walei163/swm3310/README.md

# swm3310
基于英博公司定制开发的61850转换模组，核心板采用sanway的SWA153D
