walei163/swm3310/V1.0_20260109/DOC/客户技术及验证需求/昇伟__61850_通讯核心板卡出厂测试流程及标准文档.docx

# 61850 通讯核心板卡出厂测试流程及标准文档

项目 | 内容
文档名称 | 测试文档
板卡型号 | SWA1530
文档版本 | V1.0
编制日期 | 2026.1.23
编制部门 | 廊坊研发中心
适用范围 | 供应商出厂测试、项目组内部评估
文档状态 | 初稿

## 1. 文档概述

### 1.1 目的描述

1. 验证 SWA5043 板卡61850 协议核心功能：串口转 61850 协议转换准确性、数据传输延迟、协议兼容性（MMS/GOOSE）；
2. 验证板卡硬件与配置工具可用性：网口 / 串口配置、Web 管理、程序升级、文件传输等功能有效性；
3. 明确出厂测试标准：为供应商提供可量化的测试指标、流程及判定依据，确保批量交付板卡一致性。
4. 出场时按照实际要求设置默认程序 ，默认参数

### 1.2 测试环境准备

#### 1.2.1 硬件环境（供应商需配备）

设备名称 | 规格要求 | 数量 | 用途
测试主机 | 测试电脑 | 1 台 | 运行测试工具、Web 登录配置
61850 协议分析仪 （抓包工具） | ，报文捕获 / 解析 | 1 台 | 验证 MMS/GOOSE 报文合法性
串口模拟器（Modbus Slave） | 支持 Modbus RTU/TCP 协议 | 1 台 | 模拟 PCS 串口数据输入
以太网交换机 | 网口≥4 个 | 1 台 | 连接测试主机、板卡、分析仪
直流电源 | 输出 5V（匹配板卡供电），纹波≤5% | 1 台 | 板卡供电
万用表 / 示波器 | 精度≥0.1%，支持电压 / 波形测量 | 各 1 台 | 检测供电稳定性、GPIO 状态
辅助工具 | USB-TTL 转换器、网线、5V 电源 | 若干 | 串口调试、设备互联

#### 1.2.2 软件环境（供应商需安装）

软件名称 | 版本要求 | 用途
61850 测试工具 | IEDScout/UDMView 等 | MMS 服务测试、GOOSE 订阅 / 发布验证
抓包工具 | Wireshark等 | 辅助分析以太网报文
串口调试工具 | MobaXterm、串口助手等 | 串口数据监控、板卡调试
Modbus 测试工具 | Modbus Slave等 | 模拟 PCS 串口数据输出
配置文件编辑工具 | XML 编辑器、Excel等 | 修改 icd 文件、goose.csv 配置文件
板卡配套文件 | ybdq_pcs_so_xml_v1_20260121.tar.gz（应用程序）、rs201.icd（模型文件）、goose.csv（GOOSE 配置）、protocol.xml（点表配置）等 | 板卡程序升级、功能配置

## 2. 功能验证（出厂必测项）

### 2.1 基础通讯配置功能测试

#### 测试目的

验证板卡网口、串口参数修改有效性，配置重启后是否正常生效。

#### 测试步骤

1. 初始状态检查：
  1. 板卡上电，通过 Web 登录（默认 IP），记录初始网口配置（IP 地址、子网掩码、网关）和串口配置（波特率、数据位、校验位）；
  2. 使用 ping 命令测试默认 IP 连通性，通过串口工具验证默认串口通讯正常。
1. 参数修改操作：
  3. 登录 Web 管理页面，进入 “通讯功能配置”：
    1. 网口配置：修改所有网口 IP 地址、子网掩码、网关（示例：IP=192.168.1.100，子网掩码 = 255.255.255.0，网关 = 192.168.1.1）；
    2. 串口配置：修改串口波特率（如 9600→19200）、数据位（8 位）、校验位（无）、停止位（1 位）；
    3. 启用 NTP 对时（服务器 IP=202.120.2.101），配置 GOOSE 绑定网口（如 eth1）。
1. 生效验证：
  4. 保存配置并重启板卡，等待 3 分钟后重新登录 Web；
  5. 核查网口、串口、NTP、GOOSE 网口配置是否与修改后一致；
  6. 使用新 IP 测试 ping 连通性，通过串口工具（新参数）验证串口通讯正常。

#### 判定标准

5. 配置修改后重启生效，Web 页面显示参数与修改值一致；
6. 新 IP 地址 ping 测试成功率 100%（连续 ping 100 次无丢包）；
7. 串口通讯正常，无数据丢失或乱码。

### 2.2 工具操作功能测试

#### 2.2.1 Web 登录测试

8. 测试步骤：通过测试主机浏览器输入板卡网口 IP，验证是否能正常访问 Web 管理页面（无需额外插件）；
9. 判定标准：登录响应时间≤3 秒，页面无错乱、功能按钮可正常点击。

#### 2.2.2 程序升级测试

10. 测试步骤：
  1. 进入 Web “程序升级” 页面，选择板卡配套应用程序 例如（ybdq_pcs_so_xml_v1_20260121.tar.gz）等；
  2. 点击 “上传升级”，等待升级完成（约 5 分钟），板卡自动重启；
  3. 重启后登录 Web，核查程序版本是否与升级文件一致。
11. 判定标准：升级过程无中断、无报错；重启后程序版本正确，所有功能正常。

#### 2.2.3 文件上传 / 下载测试

12. 测试步骤：
  1. 上传测试：进入 Web “文件管理”，分别上传 icd 文件（rs201.icd）、GOOSE 配置文件（goose.csv）、点表配置文件（protocol.xml）；
  2. 下载测试：上传完成后，分别下载上述文件，与原文件对比是否一致。
13. 判定标准：文件上传 / 下载成功率 100%，下载文件与原文件 MD5 值一致（无篡改、无丢失）。

#### 2.2.4 工程配置测试

14. 测试步骤：
  1. 进入 Web “工程配置”，修改 iedname（如 “PCS-61850-001”）；
  2. 选择 icd 模型文件（如rs201.icd）、设备名、协议名，设置扫描时间为 100ms；
  3. 修改系统时间；
  4. 保存配置并重启，核查配置是否生效。
15. 判定标准：iedname、icd 模型、扫描时间、系统时间修改后均生效，系统时间误差≤1 秒。

#### 2.2.5 实时库配置测试

16. 测试步骤：
  1. 由供应商提供实时库修改支持，增加 1 个模拟点位（如 “PCS_Udc”，电压类型，字节序 = 大端）；
  2. 设置该点位串口读取周期可修改为 100ms；
  3. 通过串口模拟器发送该点位数据，验证板卡是否能正常采集。
17. 判定标准：实时库配置修改后生效，点位数据采集正常，读取周期误差≤10ms。

#### 2.2.6 ICD 文件配置修改测试

18. 测试步骤：
  1. 使用 XML 编辑器修改 rs201.icd 文件（如增加 1 个遥测点位）；
  2. 上传修改后的 icd 文件至板卡，重启后通过 61850 测试工具（IEDScout）解析板卡模型；
  3. 核查解析结果是否包含新增点位。
19. 判定标准：icd 文件修改后上传生效，61850 测试工具可正确解析新增点位信息。

#### 2.2.7 GOOSE 配置修改测试

20. 测试步骤：
  1. 用 Excel 编辑 goose.csv 文件，新增 1 个 GOOSE 发布数据集（如 “Dataset1”，包含 大于3 个点位）；
  2. 上传配置文件至板卡，重启后通过 61850 协议分析仪监控 GOOSE 报文；
  3. 核查分析仪是否能捕获到新增数据集的 GOOSE 发布报文。
21. 判定标准：GOOSE 配置修改生效，协议分析仪可捕获到合法的 GOOSE 发布报文（符合 IEC 61850 标准）。

### 2.3 MMS 协议功能测试

#### 2.3.1 测试准备

22. 加载文件：板卡上传 rs201.icd（icd 模型文件）、protocol.xml（点表映射文件）；
23. 测试工具：启动 IEDScout，建立与板卡的 MMS 连接（IP = 板卡网口 IP，端口 = 102）。

#### 2.3.2 MMS 读取测试

24. 测试步骤：
  1. 在 IEDScout 中浏览板卡模型，选择遥测点位（如电压、电流）、遥信点位（如运行状态）；
  2. 发起 “读数据” 请求，连续读取 100 次，记录读取结果；
  3. 通过串口模拟器修改点位数据，验证 MMS 读取是否同步更新。
25. 判定标准：
  1. 读取成功率 100%，无超时、无错误响应；
  2. 数据更新延迟≤200ms（串口数据修改后，MMS 读取到新数据的时间）；
  3. 读取数据与串口发送数据一致。

#### 2.3.3 MMS 设置操作测试

26. 测试步骤：
  1. 在 IedScout 中选择可写遥调点位（如输出功率设定值）；
  2. 发起 “写数据” 请求（如设定值 = 50kW），连续写入 10 次；
  3. 通过串口工具监控板卡下发至 PCS 的串口数据，核查设定值是否一致。
27. 判定标准：
  1. 写入成功率 100%，无写入失败或数据篡改；
  2. 串口下发数据与 MMS 写入数据一致，延迟≤200ms。

#### 2.3.4 离散数据显示测试

28. 测试步骤：
  1. 配置板卡离散数据点位（如故障告警位、运行模式位）；
  2. 通过串口模拟器发送离散数据（0/1 切换）；
  3. 在 IEDScout 中查看离散数据显示状态。
29. 判定标准：离散数据显示与串口发送状态一致，切换延迟≤100ms，无抖动。

### 2.4 GOOSE 协议功能测试

#### 2.4.1 测试准备

30. 加载文件：板卡上传 goose.csv（GOOSE 配置文件）、rs201.icd（icd 模型文件）、protocol.xml（点表映射文件）；
31. 测试工具：启动 61850 协议分析仪，接入板卡 GOOSE 网口。

#### 2.4.2 GOOSE 发送测试

32. 测试步骤：
  1. 板卡配置为 GOOSE 发布端，启用已配置的 GOOSE 数据集（如 Dataset1）；
  2. 通过串口模拟器发送数据集对应的点位数据（如电压 = 380V、电流 = 100A）；
  3. 协议分析仪捕获 GOOSE 报文，分析报文格式、数据集内容、发送周期。
33. 判定标准：
  1. GOOSE 报文符合 IEC 61850-8-1 标准，无格式错误。
  2. 报文发送周期与配置一致。
  3. 数据内容与串口发送数据一致。

#### 2.4.3 GOOSE 订阅测试

34. 测试步骤：
  1. 配置另一台 61850 设备作为 GOOSE 发布端，发送数据集（如 Dataset2，包含故障告警、电压值）；
  2. 板卡配置为 GOOSE 订阅端，订阅 Dataset2；
  3. 发布端修改数据集数据（如故障告警 = 1、电压 = 385V）；
  4. 通过板卡 Web 或串口工具查看订阅数据是否更新。
35. 判定标准：
  1. 板卡能成功订阅 GOOSE 报文，订阅成功率 100%；
  2. 订阅数据更新与发布端一致，延迟符合现场要求（符合储能 PCS 实时性要求）。

### 2.5 多网口兼容性测试

#### 测试步骤

1. 依次配置板卡所有网口（如 eth0、eth1、eth2）的 IP 地址（不同网段）；
2. 分别通过每个网口进行 MMS 通讯测试（读取 / 写入数据）、GOOSE 通讯测试（发布 / 订阅）；
3. 同时通过多个网口发起测试请求（如 eth0 进行 MMS 读取，eth1 进行 GOOSE 发送），持续 30 分钟。
36. 判定标准：
  1. 所有网口均能正常进行 MMS/GOOSE 通讯，无端口冲突；
  2. 多网口并发通讯时，无数据丢失、无响应超时，延迟符合要求。

## 3. 稳定性测试（出厂抽检项）

### 测试目的

验证板卡在长时间运行下的稳定性和可靠性。

### 测试步骤

1. 板卡正常配置后，连续运行 72 小时（模拟实际工况）；
2. 期间持续进行：
  3. MMS 通讯：每 100ms 读取 1 次遥测数据，每 1 秒写入 1 次遥调数据；
  4. GOOSE 通讯：每 50ms 发送 1 次 GOOSE 报文，订阅 1 路外部 GOOSE 数据；
  5. 串口数据交互：每 50ms 接收 PCS 模拟数据，每 1 秒下发控制指令；
1. 定期（每 2 小时）核查：
  6. 数据传输成功率、延迟是否符合标准；
  7. 板卡运行状态（温度、供电、无死机 / 重启）；
  8. 日志无报错信息。

### 判定标准

37. 72 小时运行期间，板卡无死机、无自动重启，供电稳定；
38. MMS/GOOSE/ 串口数据传输成功率≥99.99%，无数据丢失；
39. 延迟指标始终符合各功能测试要求，无明显漂移；
40. 运行日志无协议错误、通讯超时等异常记录。

## 4. 测试判定标准与记录

### 4.1 测试结果判定规则

测试结果等级 | 判定条件 | 处理方式
合格 | 所有必测项满足判定标准，抽检项（稳定性测试）无异常 | 允许出厂交付
不合格 | 任一必测项不满足判定标准，或抽检项出现严重异常（如死机、数据丢失） | 退回整改，整改后重新测试
待确认 | 个别测试项存在轻微偏差（如延迟偶尔超出范围），但不影响核心功能 | 复核测试，确认是否为偶然因素

### 4.2 出厂测试记录表格（供应商需填写）

#### 表 4-1 基础信息记录

板卡序列号 | 测试日期 | 测试人员 | 测试环境版本 | 备注

#### 表 4-2 功能测试记录

测试项目 | 测试用例 | 测试结果（合格 / 不合格 / 待确认） | 异常描述（若有） | 备注
基础通讯配置 | 网口参数修改生效
| 串口参数修改生效
| NTP 对时功能
工具操作 | Web 登录
| 程序升级
| 文件上传 / 下载
| 工程配置
| 实时库配置
MMS 功能 | 读取测试
| 写入测试
| 离散数据显示
GOOSE 功能 | 发送测试
| 订阅测试
多网口测试 | 多网口并发通讯

#### 表 4-3 稳定性测试记录（抽检）

测试时长 | 数据传输成功率 | 平均延迟 | 板卡运行状态 | 异常描述（若有） | 备注
24 小时
48 小时
72 小时

#### 表 4-4 测试结论

测试结论 | □ 合格 □ 不合格 □ 待确认
签字确认 | 测试人员：
| 审核人员：
| 日期：

## 5. 注意事项与异常处理

### 5.1 测试注意事项

1. 板卡上电前需确认供电电压与板卡要求一致（避免过压损坏）；
2. 配置文件（icd、goose.csv、protocol.xml）上传前需备份原文件，避免覆盖错误；
3. 修改 icd 文件点位信息时，需严格遵循 IEC 61850-6 标准，不建议自行修改核心点位；
4. Web 配置后需重启板卡才能生效，重启前需保存所有配置；
5. 多网口测试时，需确保各网口 IP 地址在不同网段，避免 IP 冲突；
6. 稳定性测试期间，禁止中断板卡供电或修改配置。

### 5.2 常见异常处理

异常现象 | 可能原因 | 处理方法
Web 登录失败 | IP 地址错误、网口未启用、网络不通 | 1. 核查板卡 IP 配置；2. 测试主机与板卡 ping 连通性；3. 更换网线或网口
配置文件上传失败 | 文件格式错误、文件过大 | 1. 确认文件符合要求（如 icd 为 XML 格式）；2. 拆分超大文件（若支持）；3. 刷新 Web 页面重试
MMS/GOOSE 通讯失败 | 模型文件加载错误、协议配置错误 | 1. 核查 icd 文件是否正确加载；2. 检查协议配置参数（如端口、数据集）；3. 用 Wireshark 抓包分析报文
数据传输延迟超标 | 网络拥堵、串口读取周期设置过大 | 1. 减少网络并发量；2. 调整串口读取周期或 GOOSE 发送周期；3. 检查网线质量（使用千兆网线）
板卡死机 / 重启 | 供电不稳定、程序异常 | 1. 用示波器检测供电纹波；2. 重新升级板卡程序；3. 记录死机前操作，反馈研发排查

## 6. 附录（测试用表）

### 附录 A：MD5 值校验表

配置文件名称 | 原文件 MD5 值 | 下载后 MD5 值 | 一致性判定（是 / 否）
rs201.icd
goose.csv
protocol.xml

### 附录 B：61850 协议测试关键指标参考

参考相关标准

指标类型 | 要求值 | 测试工具
MMS 读取延迟 | | IEDScout + 秒表
MMS 写入延迟 | | IEDScout + 秒表
GOOSE 发送周期误差 | | 61850 协议分析仪
GOOSE 订阅延迟 | | 61850 协议分析仪
数据传输成功率 | | 测试工具统计
