walei163/swm3310/V1.0_20260109/DOC/9pin接插件数据手册.png

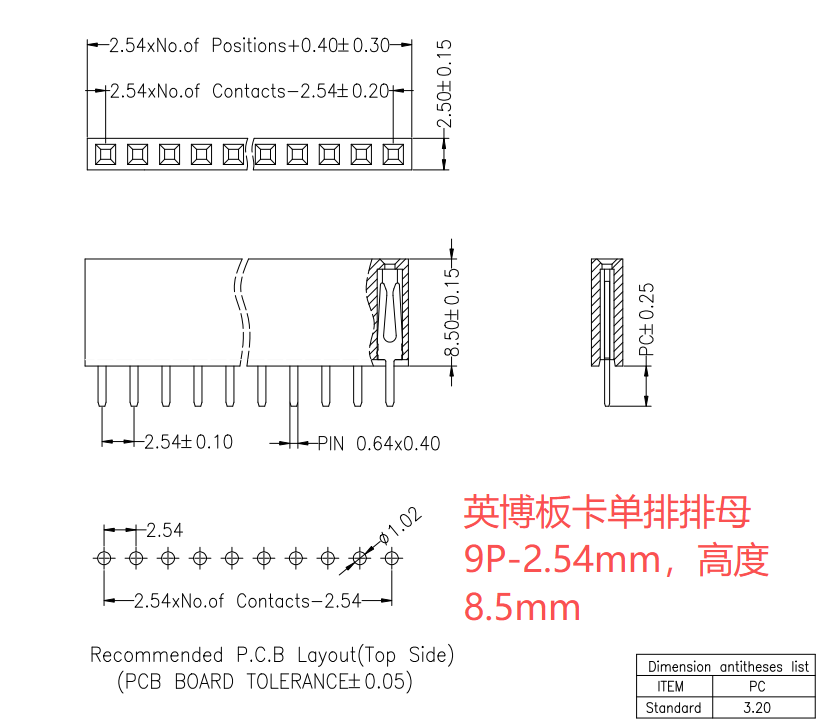
V1.0_20260109/DOC/9pin接插件数据手册.png
