walei163/swm3310/V1.0_20260109/DOC/images/image-20260109160413757.png

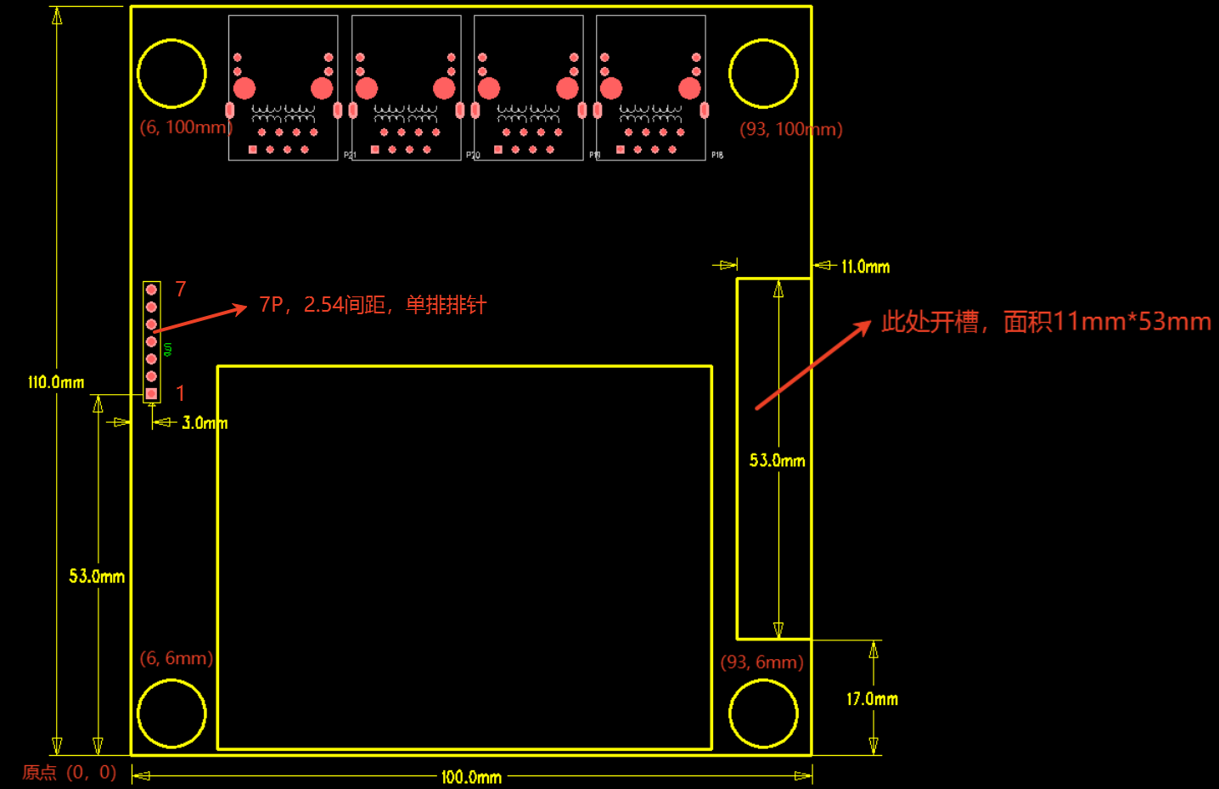
V1.0_20260109/DOC/images/image-20260109160413757.png
