walei163/swm3310/V1.0_20260109/DOC/客户方板卡CAN总线连接原理图.png

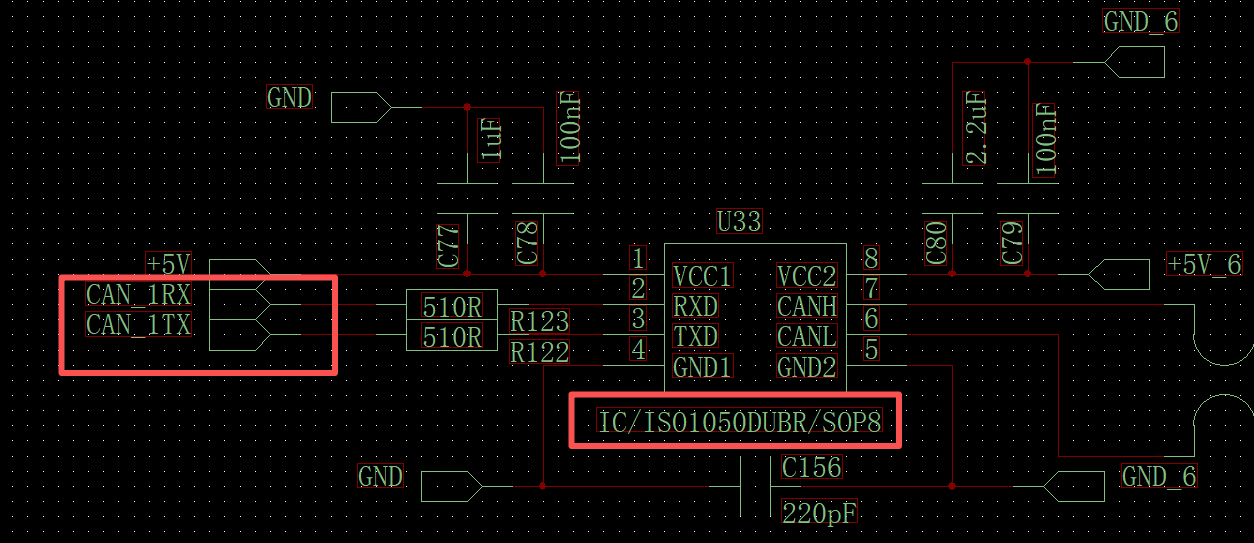
V1.0_20260109/DOC/客户方板卡CAN总线连接原理图.png
