walei163/swm3310/V1.0_20260109/DOC/接口尺寸图1.png

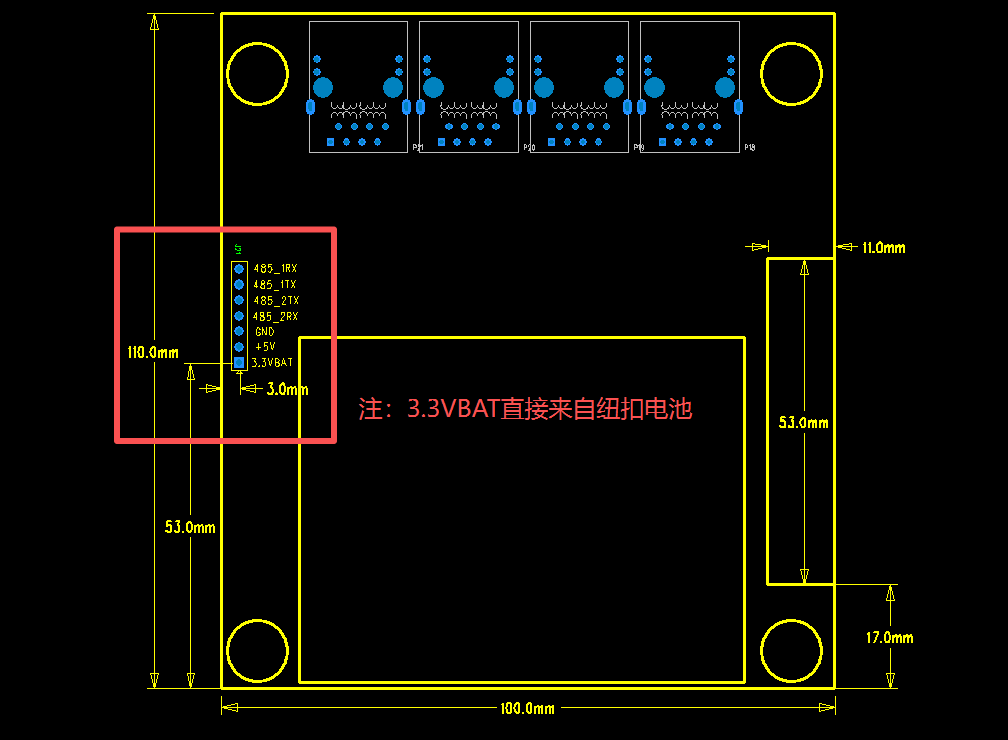
V1.0_20260109/DOC/接口尺寸图1.png
