walei163/swm3310/V1.0_20260109/PCB布局/SWM3310-0121.dxf

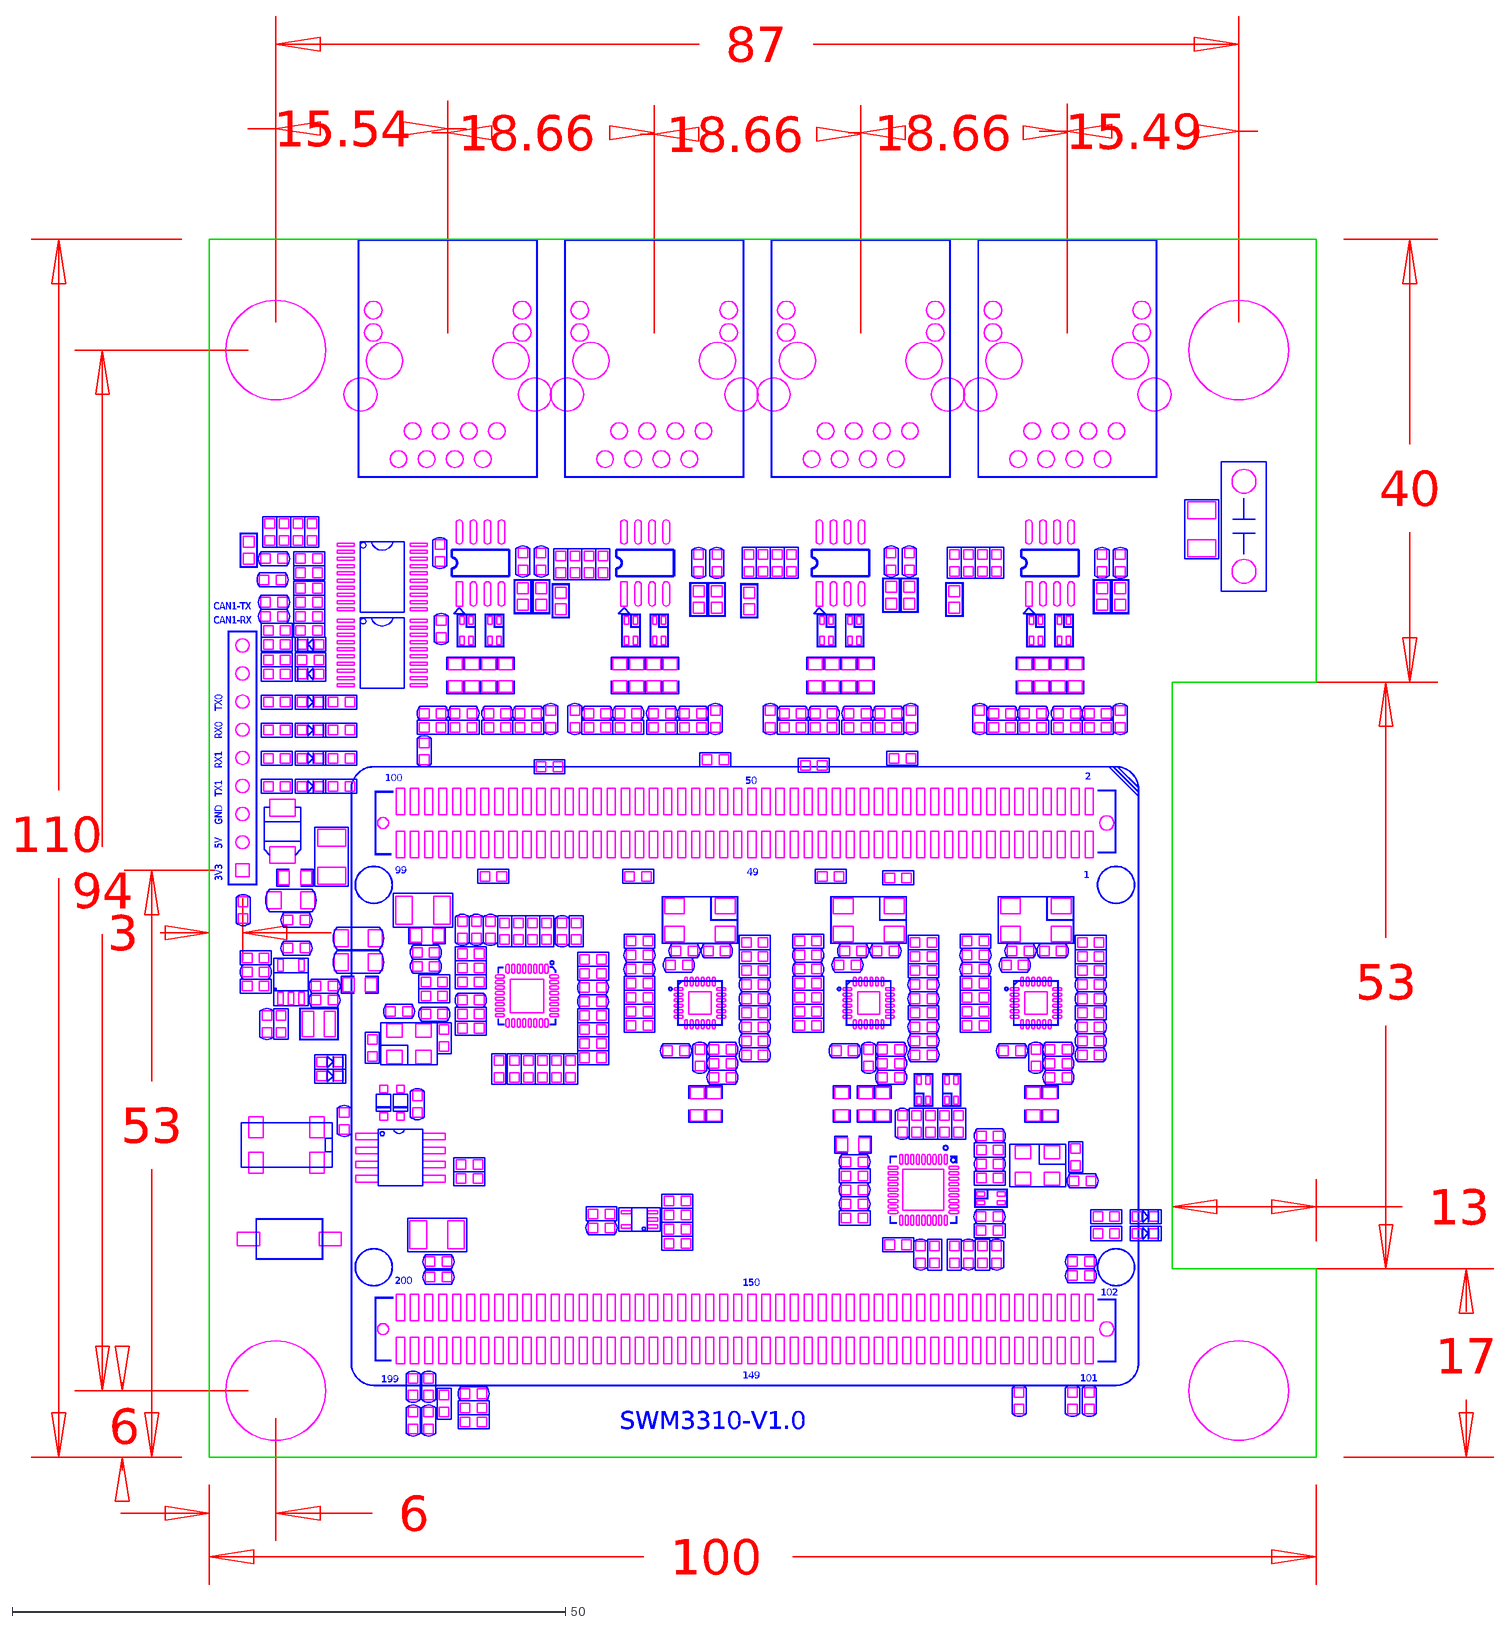
[picture p12: CAD file, 2026-01-28]
V1.0_20260109/PCB布局/SWM3310-0121.dxf
94
3
53
15.54
15.49
18.66
87
6
40
13
17
110
100
99
2
1
49
50
149
150
102
101
199
200
TX0
RX0
RX1
TX1
GND
5V
3V3
CAN1-RX
CAN1-TX
SWM3310-V1.0
