walei163/swm3310/V1.0_20260109/SCH/swm3310_SCH_V1.0_20260121.pdf

D | D

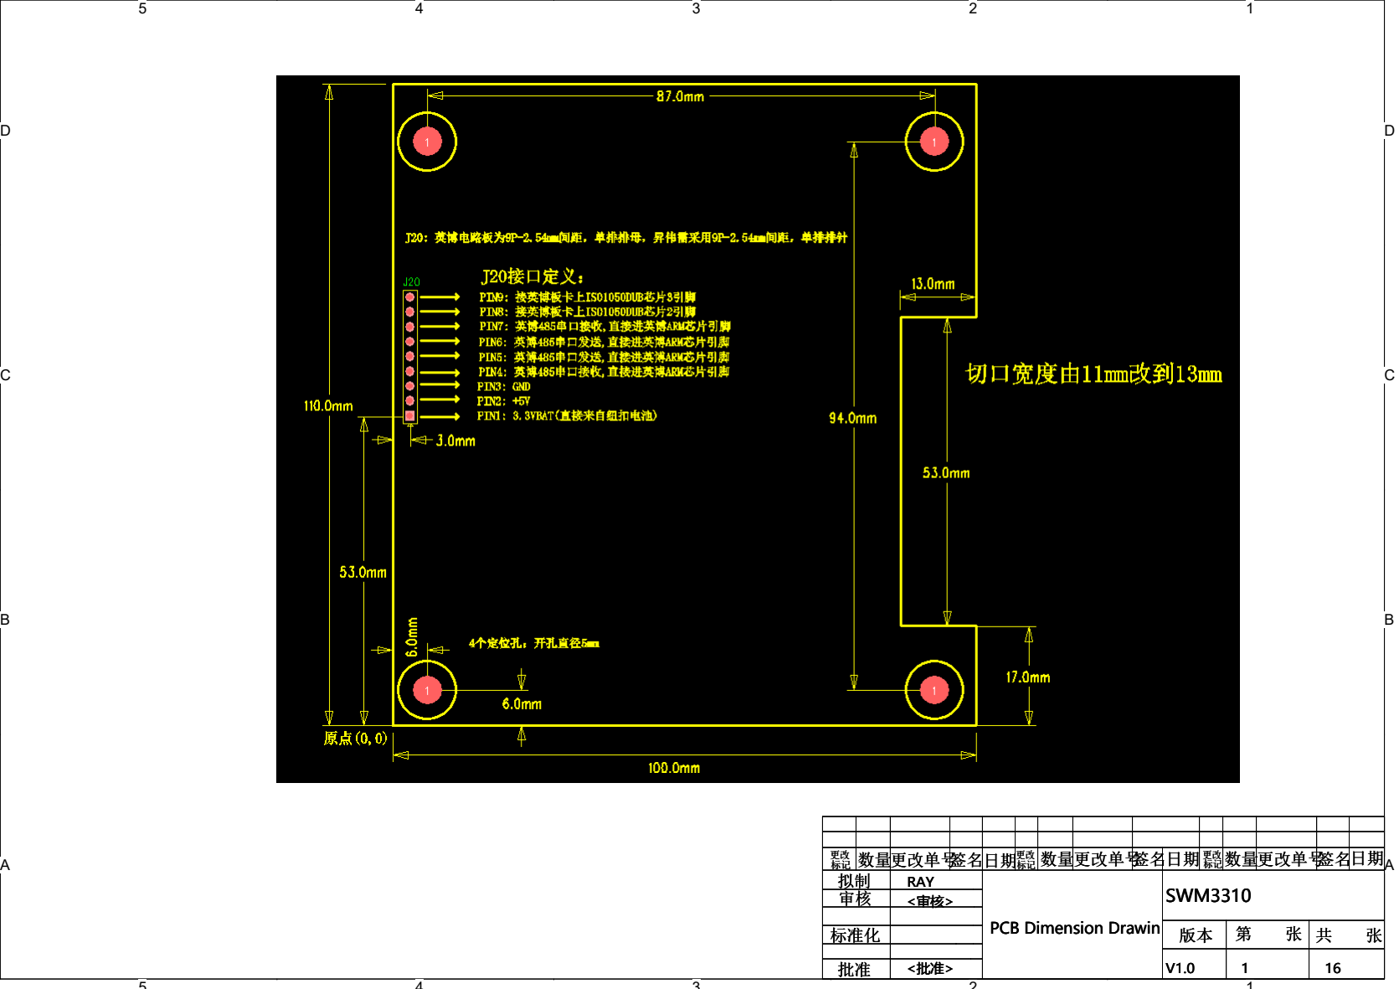
[picture p43: page 1]

C | C
B | B
A | 标标 | 数数更更更更签签日日 | A 更更
批批 | <批准>
版版 | 第　　张 | 共　　张
V1.0 V1.0 V1.0 | 1 1 1 | 16 16 16
标 标 | 数更更签日 更 数更更签日 更 | | | 更 更 更 标 标 标 | 数更更 数更更 数更更 | | 签 签日 更标 数更更 签 签日 更标 数更更 签 签日 更标 数更更 | 日 日 日
拟拟 拟拟 拟拟 | | RAY RAY RAY | PCB Dimension Drawin PCB Dimension Drawin PCB Dimension Drawin | | | SWM3310 SWM3310 SWM3310
审审 审审 审审 | | <审核> <审核> <审核>

# 标批标

D | D
C | C
B | B
A | A

34

2 | 系统逻辑框图
3 | 核心板对底板接插件1
4 | 核心板对底板接插件2
5 | USB HUB，将CPU第2路USB HOST扩展为4路输出
10 | 第3路以太网：采用USB扩展SR9900AI
11 | 第3路以太网RJ45接口电路

01/13/26

封面

1.1 6

13 | 第4路以太网RJ45接口电路
14 | 其它设计
15 | 主5V和主3.3V电源电路
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
PAGE NO.

7 | 第1路以太网RJ45接口电路
8 | 第2路以太网：采用USB扩展SR9900AI

## RAY

2.1

# REV

# FEATURE CHANGES

## 1、完完1.0版版版版版版版。

BY

2.2

9

# SCHEMATIC PAGE

# DESCRIPTION

## RAY

12

1.0

# DATE

# 第1路以太网PHY：采用RTL8201F PHY芯片

# 第2路以太网RJ45接口电路

# 第4路以太网：采用USB扩展SR9900AI

标 标 标 | 数更更签日 更 数更更签日 更 数更更签日 更 | | | 更 更 更 标 标 标 | 数更更 数更更 数更更 | | 签 签日 更标 数更更 签 签日 更标 数更更 签 签日 更标 数更更 | 日 日 日
拟拟 拟拟 拟拟 | | RAY.Wang RAY.Wang RAY.Wang | COVER COVER COVER | | | SWM3310 SWM3310 SWM3310
审审
<审核>
V1.0 | 2 | 16

审审
<审核>
V1.0 | 2 | 16

审审
<审核>
V1.0 | 2 | 16

UART X 3 TTL; PHY RTL8201F (100M); USB 2.0 X 1 (HOST); RMII; USB2512 (HUB); SIP7; SWA157D (STM32MP157DAA1)

标 标 标 | 数更更签日 更 数更更签日 更 数更更签日 更 | | | 更 更 更 标 标 标 | 数更更 数更更 数更更 | | 签 签日 更标 数更更 签 签日 更标 数更更 签 签日 更标 数更更 | 日 日 日
拟拟 拟拟 拟拟 | | RAY.Wang RAY.Wang RAY.Wang | SYSTEM_LOGIC SYSTEM_LOGIC SYSTEM_LOGIC | | | SWM3310 SWM3310 SWM3310

D | D


标 标 标 | 数更更签日 更 数更更签日 更 数更更签日 更 | | | 更 更 更 标 标 标 | 数更更 数更更 数更更 | | 签 签日 更标 数更更 签 签日 更标 数更更 签 签日 更标 数更更 | 日 日 日
拟拟 拟拟 拟拟 | | RAY.Wang RAY.Wang RAY.Wang | CPU_CONNECTOR1 CPU_CONNECTOR1 CPU_CONNECTOR1 | | | SWM3310 SWM3310 SWM3310
审审 审审 审审 | | <审核> <审核> <审核>

D | D

说明：


标 标 标 | 数更更签日 更 数更更签日 更 数更更签日 更 | | | 更 更 更 标 标 标 | 数更更 数更更 数更更 | | 签 签日 更标 数更更 签 签日 更标 数更更 签 签日 更标 数更更 | 日 日 日
拟拟 拟拟 拟拟 | | RAY.Wang RAY.Wang RAY.Wang | CPU_CONNECTOR2 CPU_CONNECTOR2 CPU_CONNECTOR2 | | | SWM3310 SWM3310 SWM3310
审审 审审 审审 | | <审核> <审核> <审核>

D | D

## Uptream


NON_REM[1:0] = 10: port 1 and 2 are non-removable
CFG_SEL[1:0] = 00

标 标 标 | 数更更签日 更 数更更签日 更 数更更签日 更 | | | 更 更 更 标 标 标 | 数更更 数更更 数更更 | | 签 签日 更标 数更更 签 签日 更标 数更更 签 签日 更标 数更更 | 日 日 日
拟拟 拟拟 拟拟 | | RAY.Wang RAY.Wang RAY.Wang | USB_HUB USB_HUB USB_HUB | | | SWM3310 SWM3310 SWM3310
审审 审审 审审 | | <审核> <审核> <审核>

D | D


标 标 标 | 数更更签日 更 数更更签日 更 数更更签日 更 | | | 更 更 更 标 标 标 | 数更更 数更更 数更更 | | 签 签日 更标 数更更 签 签日 更标 数更更 签 签日 更标 数更更 | 日 日 日
拟拟 拟拟 拟拟 | | RAY.Wang RAY.Wang RAY.Wang | PHY_RTL8201F PHY_RTL8201F PHY_RTL8201F | | | SWM3310 SWM3310 SWM3310
审审 审审 审审 | | <审核> <审核> <审核>

D | D


7 | | ENET1_TXP ENET1_TXN ENET1_RXP ENET1_RXN

标 标 标 | 数更更签日 更 数更更签日 更 数更更签日 更 | | | 更 更 更 标 标 标 | 数更更 数更更 数更更 | | 签 签日 更标 数更更 签 签日 更标 数更更 签 签日 更标 数更更 | 日 日 日
拟拟 拟拟 拟拟 | | RAY.Wang RAY.Wang RAY.Wang | PHY_RJ45 PHY_RJ45 PHY_RJ45 | | | SWM3310 SWM3310 SWM3310
审审 审审 审审 | | <审核> <审核> <审核>

D | D


标 标 标 | 数更更签日 更 数更更签日 更 数更更签日 更 | | | 更 更 更 标 标 标 | 数更更 数更更 数更更 | | 签 签日 更标 数更更 签 签日 更标 数更更 签 签日 更标 数更更 | 日 日 日
拟拟 拟拟 拟拟 | | RAY.Wang RAY.Wang RAY.Wang | ENET2_SR9900AI ENET2_SR9900AI ENET2_SR9900AI | | | SWM3310 SWM3310 SWM3310
审审 审审 审审 | | <审核> <审核> <审核>

D | D


7 | | TSEC2_TXP TSEC2_TXN TSEC2_RXP TSEC2_RXN

标 标 标 | 数更更签日 更 数更更签日 更 数更更签日 更 | | | 更 更 更 标 标 标 | 数更更 数更更 数更更 | | 签 签日 更标 数更更 签 签日 更标 数更更 签 签日 更标 数更更 | 日 日 日
拟拟 拟拟 拟拟 | | RAY.Wang RAY.Wang RAY.Wang | ENET2_RJ45 ENET2_RJ45 ENET2_RJ45 | | | SWM3310 SWM3310 SWM3310
审审 审审 审审 | | <审核> <审核> <审核>

D | D


标 标 标 | 数更更签日 更 数更更签日 更 数更更签日 更 | | | 更 更 更 标 标 标 | 数更更 数更更 数更更 | | 签 签日 更标 数更更 签 签日 更标 数更更 签 签日 更标 数更更 | 日 日 日
拟拟 拟拟 拟拟 | | RAY.Wang RAY.Wang RAY.Wang | ENET3_SR9900A ENET3_SR9900A ENET3_SR9900A | | | SWM3310 SWM3310 SWM3310
审审 审审 审审 | | <审核> <审核> <审核>

D | D


标 标 标 | 数更更签日 更 数更更签日 更 数更更签日 更 | | | 更 更 更 标 标 标 | 数更更 数更更 数更更 | | 签 签日 更标 数更更 签 签日 更标 数更更 签 签日 更标 数更更 | 日 日 日
拟拟 拟拟 拟拟 | | RAY.Wang RAY.Wang RAY.Wang | ENET3_RJ45 ENET3_RJ45 ENET3_RJ45 | | | SWM3310 SWM3310 SWM3310
审审 审审 审审 | | <审核> <审核> <审核>

D | D


标 标 标 | 数更更签日 更 数更更签日 更 数更更签日 更 | | | 更 更 更 标 标 标 | 数更更 数更更 数更更 | | 签 签日 更标 数更更 签 签日 更标 数更更 签 签日 更标 数更更 | 日 日 日
拟拟 拟拟 拟拟 | | RAY.Wang RAY.Wang RAY.Wang | ENET4_SR9900A ENET4_SR9900A ENET4_SR9900A | | | SWM3310 SWM3310 SWM3310
审审 审审 审审 | | <审核> <审核> <审核>

D | D

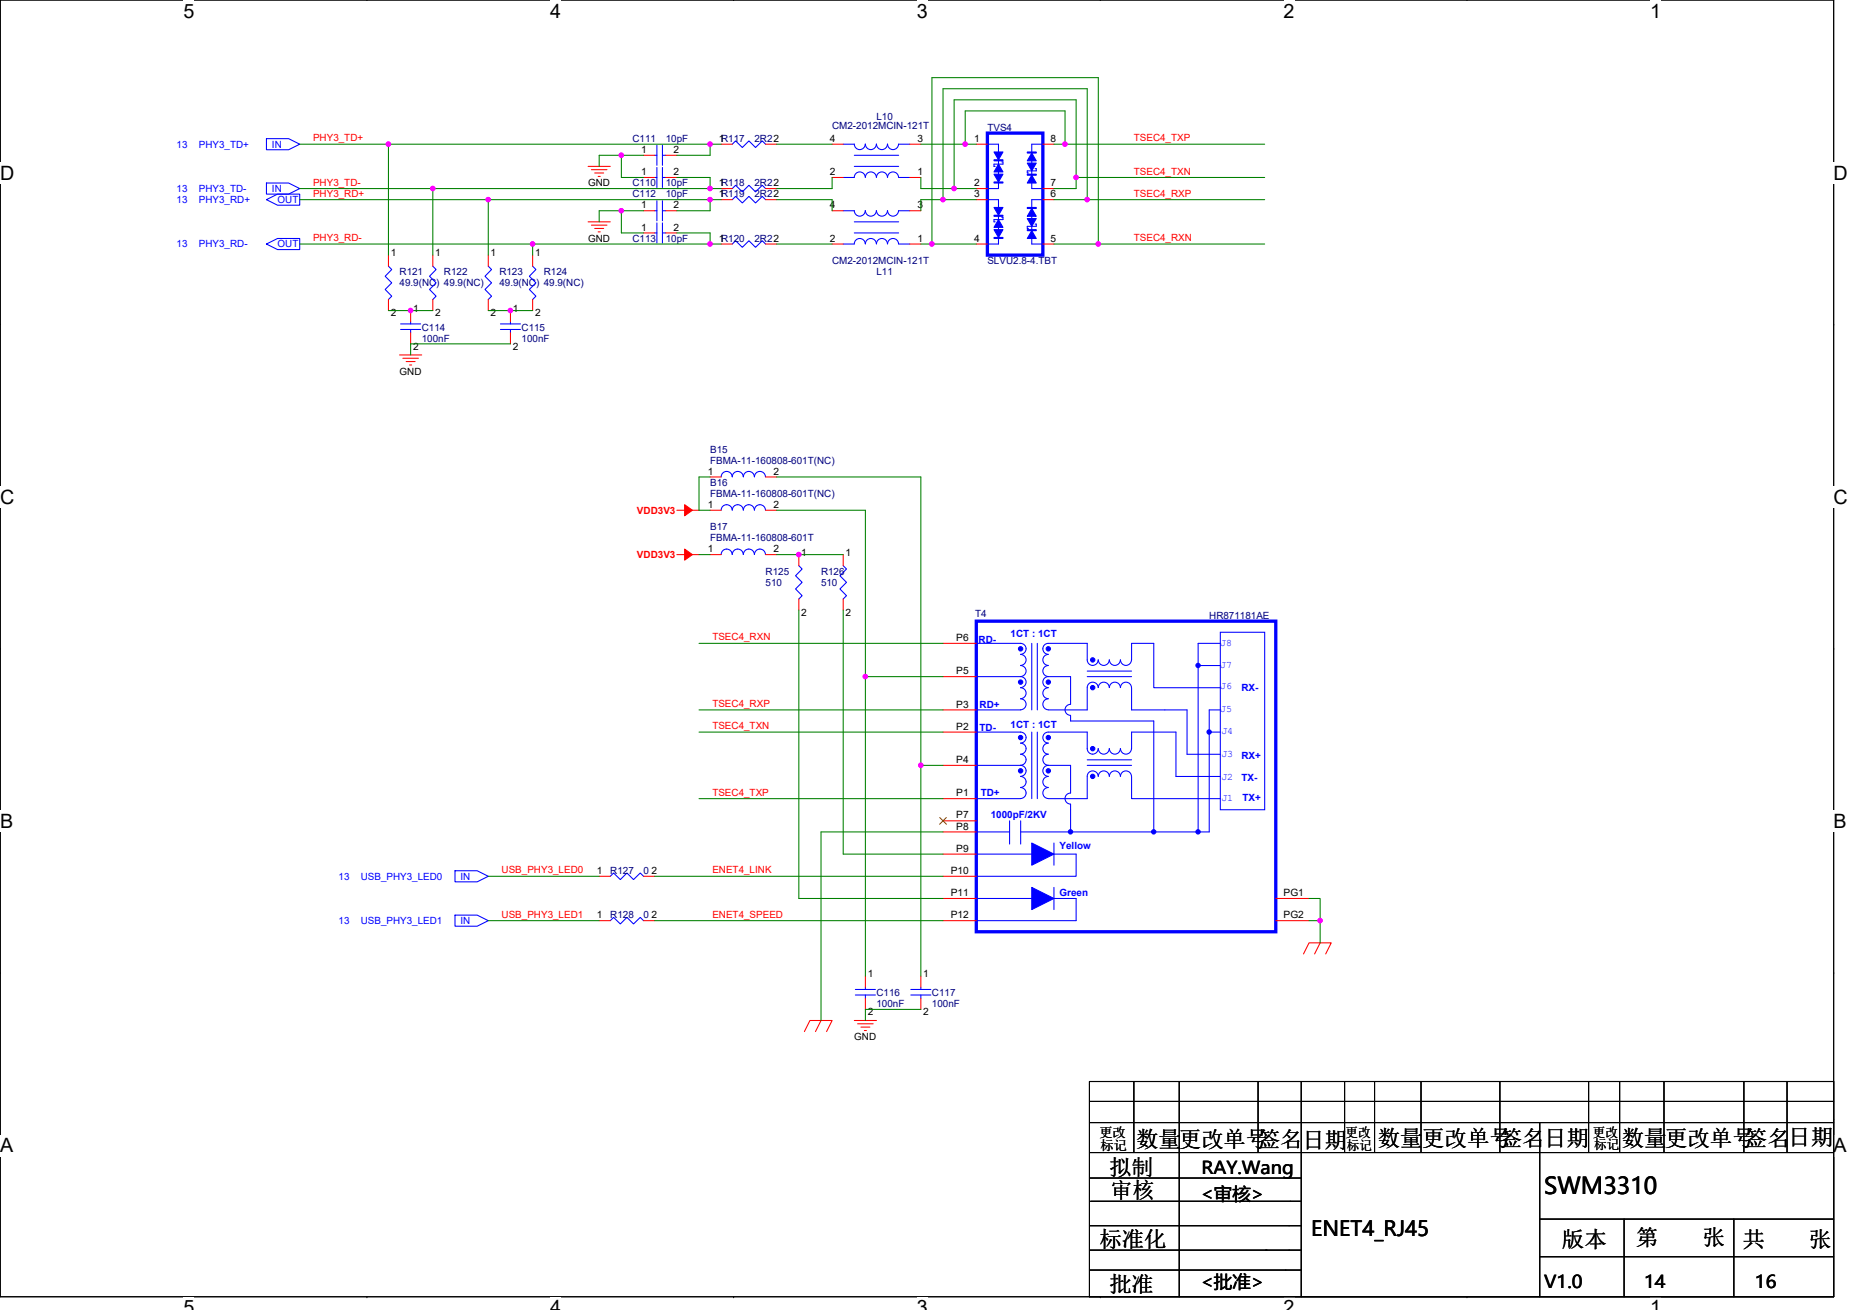
[picture p44: page 14]

标 标 标 | 数更更签日 更 数更更签日 更 数更更签日 更 | | | 更 更 更 标 标 标 | 数更更 数更更 数更更 | | 签 签日 更标 数更更 签 签日 更标 数更更 签 签日 更标 数更更 | 日 日 日
拟拟 拟拟 拟拟 | | RAY.Wang RAY.Wang RAY.Wang | ENET4_RJ45 ENET4_RJ45 ENET4_RJ45 | | | SWM3310 SWM3310 SWM3310
审审 审审 审审 | | <审核> <审核> <审核>

D | D

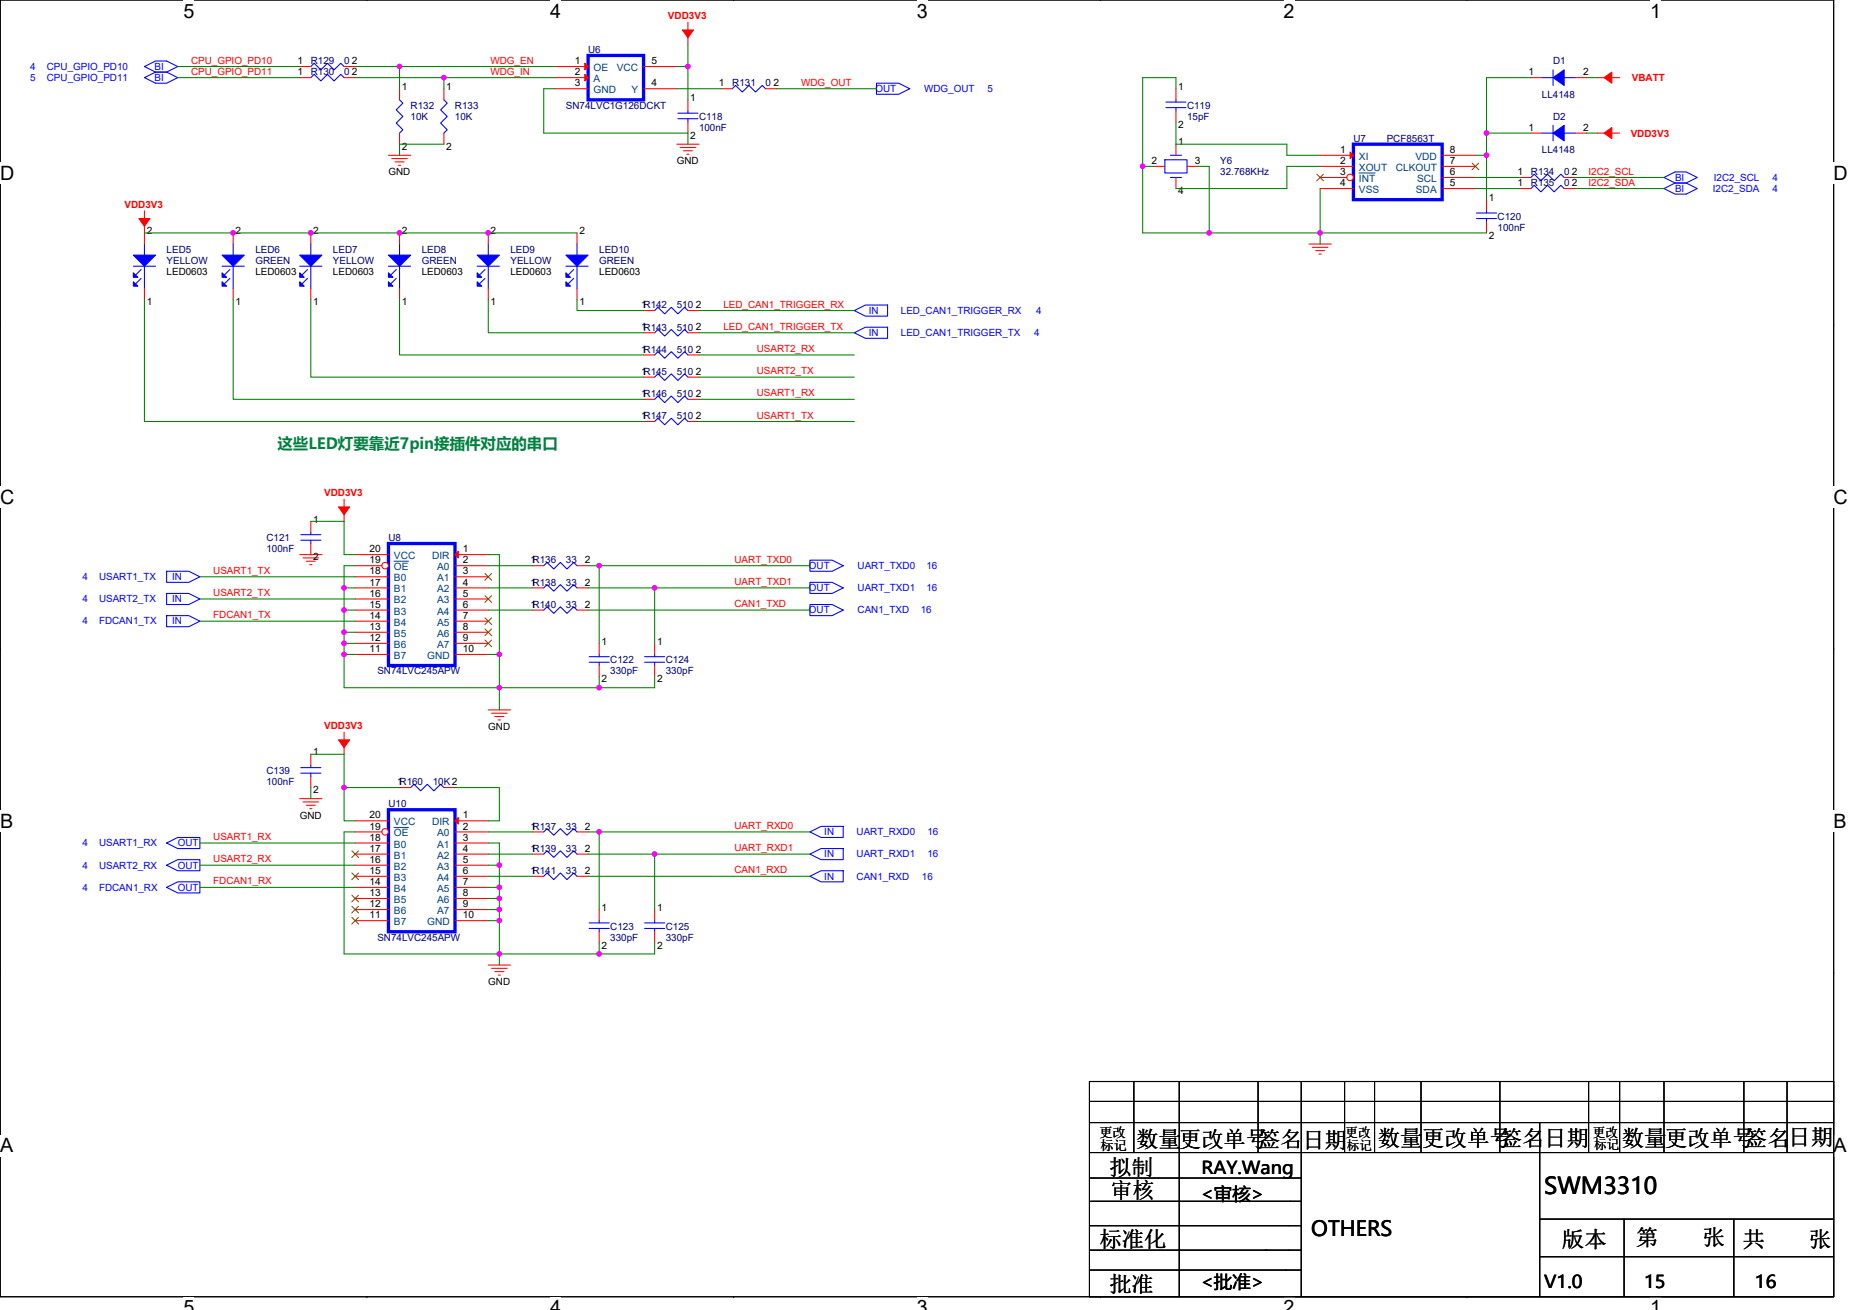
[picture p45: page 15]

标 标 标 | 数更更签日 更 数更更签日 更 数更更签日 更 | | | 更 更 更 标 标 标 | 数更更 数更更 数更更 | | 签 签日 更标 数更更 签 签日 更标 数更更 签 签日 更标 数更更 | 日 日 日
拟拟 拟拟 拟拟 | | RAY.Wang RAY.Wang RAY.Wang | OTHERS OTHERS OTHERS | | | SWM3310 SWM3310 SWM3310
审审 审审 审审 | | <审核> <审核> <审核>

D | D

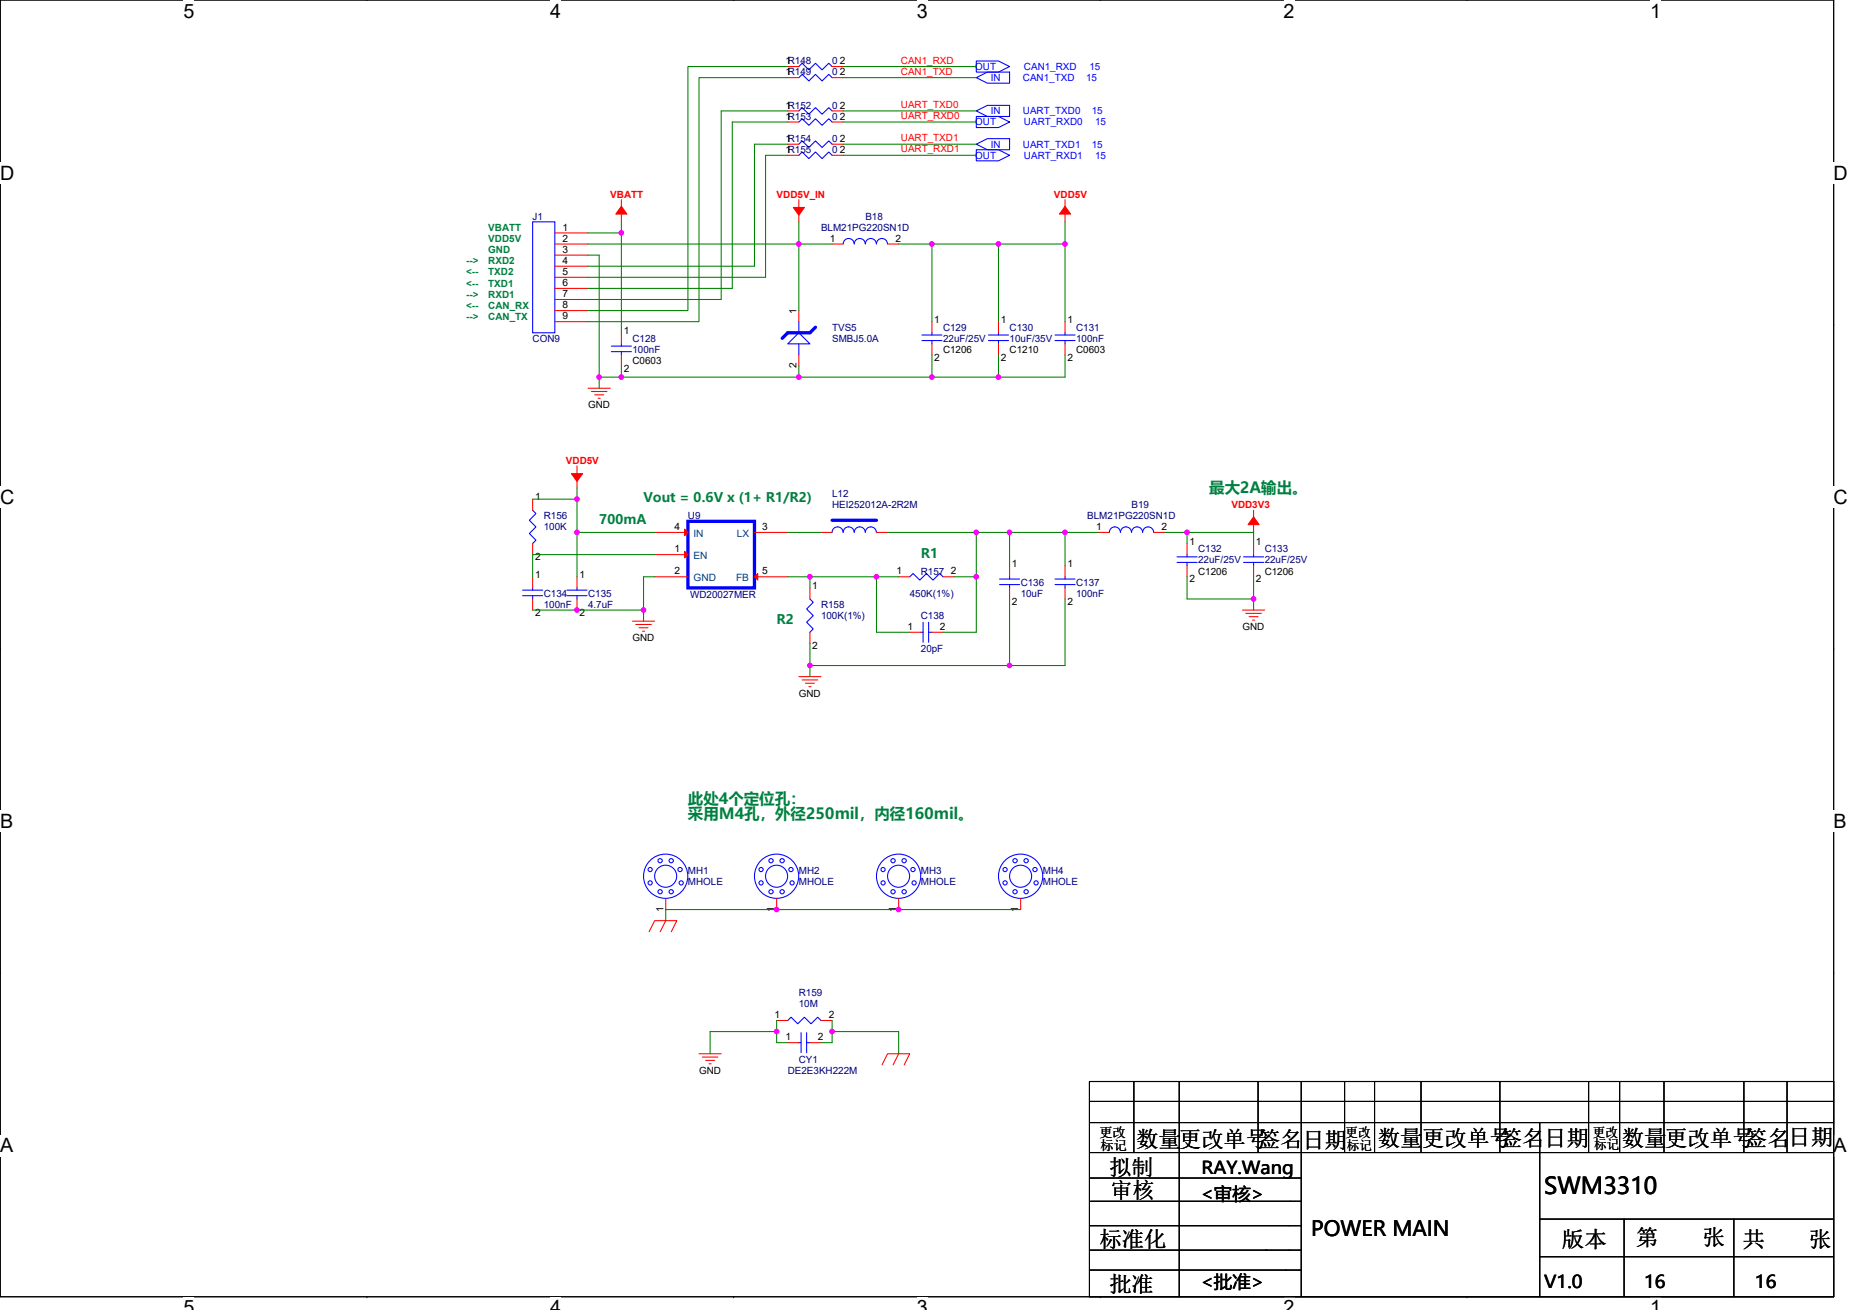
[picture p46: page 16]

标 标 标 | 数更更签日 更 数更更签日 更 数更更签日 更 | | | 更 更 更 标 标 标 | 数更更 数更更 数更更 | | 签 签日 更标 数更更 签 签日 更标 数更更 签 签日 更标 数更更 | 日 日 日
拟拟 拟拟 拟拟 | | RAY.Wang RAY.Wang RAY.Wang | POWER MAIN POWER MAIN POWER MAIN | | | SWM3310 SWM3310 SWM3310
审审 审审 审审 | | <审核> <审核> <审核>
