walei163/swm3310/(list of files, drawings)

Other design files:
V1.0_20260109/SCH/SWM3310_V1.0_20260109.DSN
V1.0_20260109/SCH/SWM3310_V1.0_20260109.opj
