walei163/swm3310/(commit log)

2026-01-28 将英博定制模组SWM3310纳入github管理
    [SWM3310-0121.dxf, SWM3310_V1.0_20260109.DSN, SWM3310_V1.0_20260109.csv, SWM3310_V1.0_20260109.opj, SWM3310_V10.brd, cases.cfg]
2026-02-05 添加V1.0版本的软件更新包
